yholinocomun/plant_ide/balancin/data/sim_fopid.png

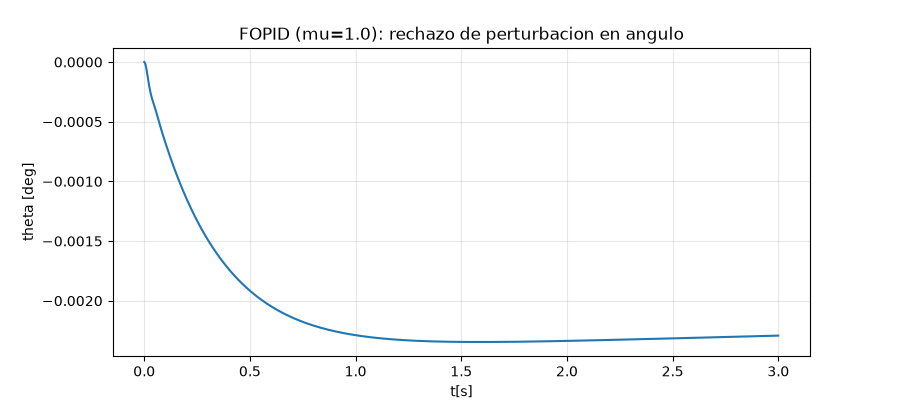
balancin/data/sim_fopid.png
