yholinocomun/plant_ide/balancin/data/sim_hinf.png

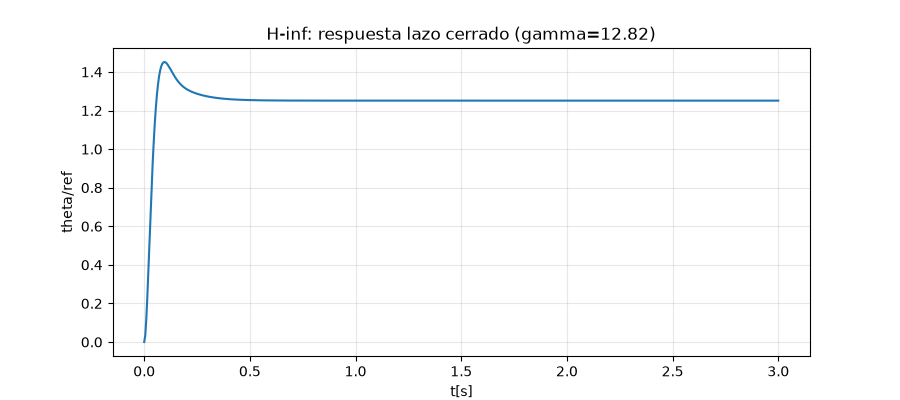
balancin/data/sim_hinf.png
