yholinocomun/plant_ide/balancin/data/sim_imc.png

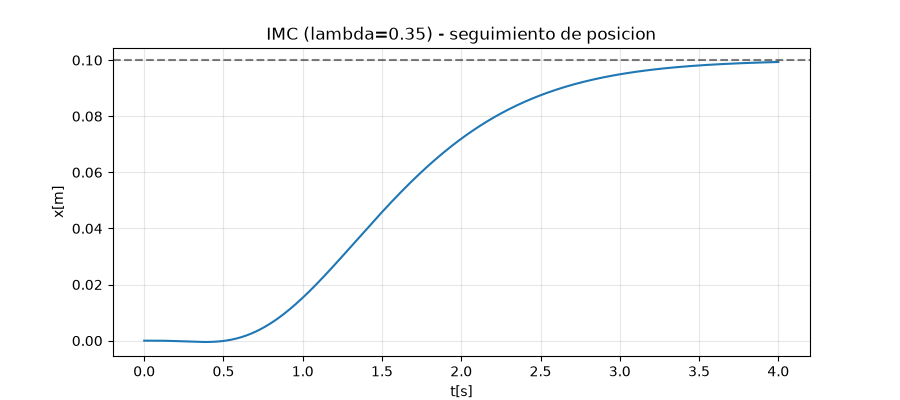
balancin/data/sim_imc.png
