yholinocomun/plant_ide/balancin/data/sim_lqg.png

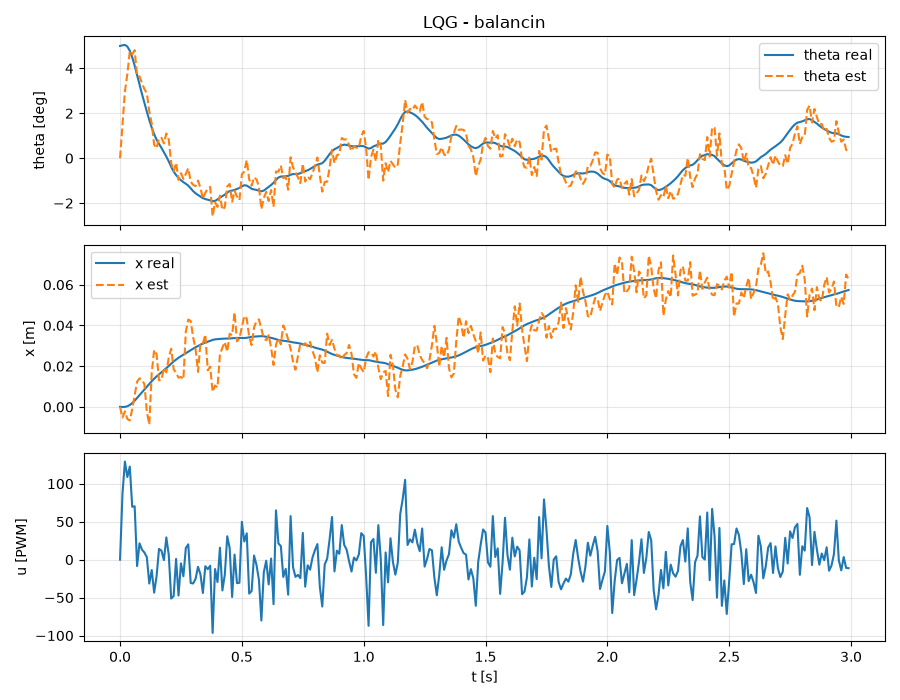
balancin/data/sim_lqg.png
