yholinocomun/plant_ide/balancin/data/sim_mpc.png

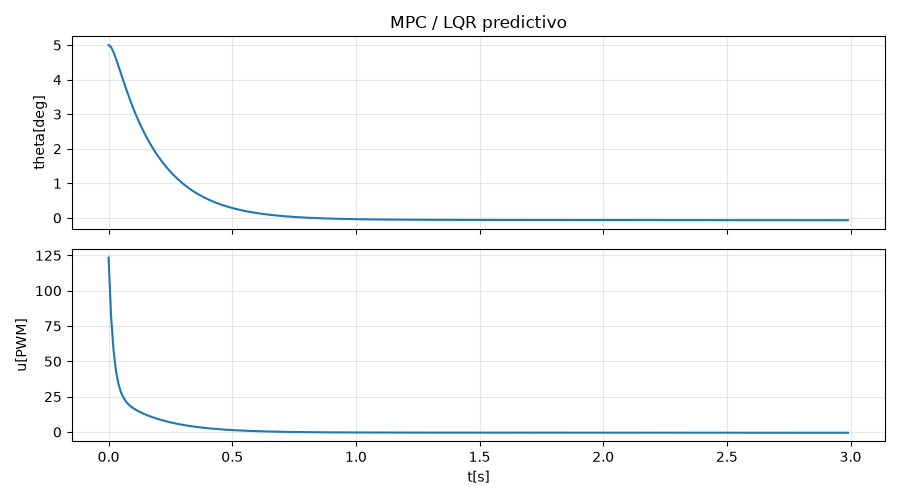
balancin/data/sim_mpc.png
