yholinocomun/plant_ide/balancin/proyecto/matlab_comparativa/cascada_sim.png

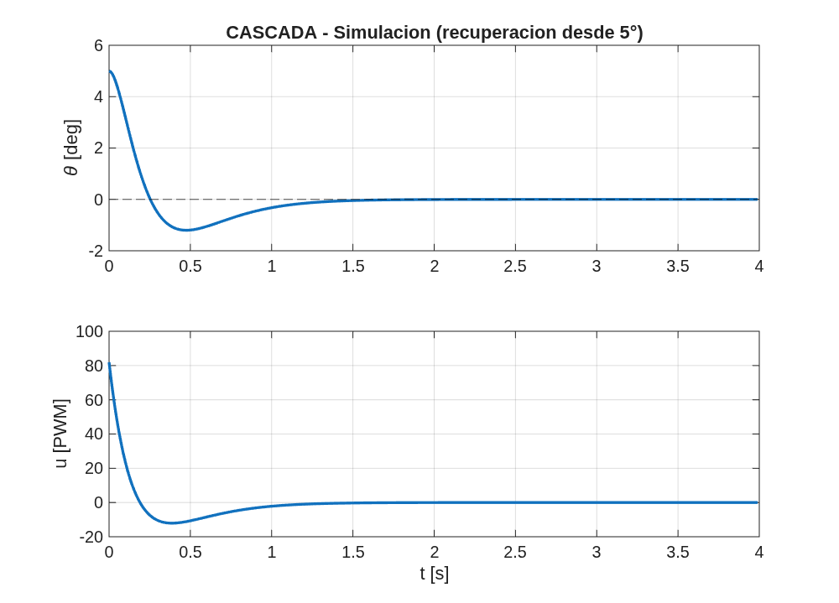
balancin/proyecto/matlab_comparativa/cascada_sim.png
