yholinocomun/plant_ide/balancin/proyecto/matlab_comparativa/fopid_comparativa.png

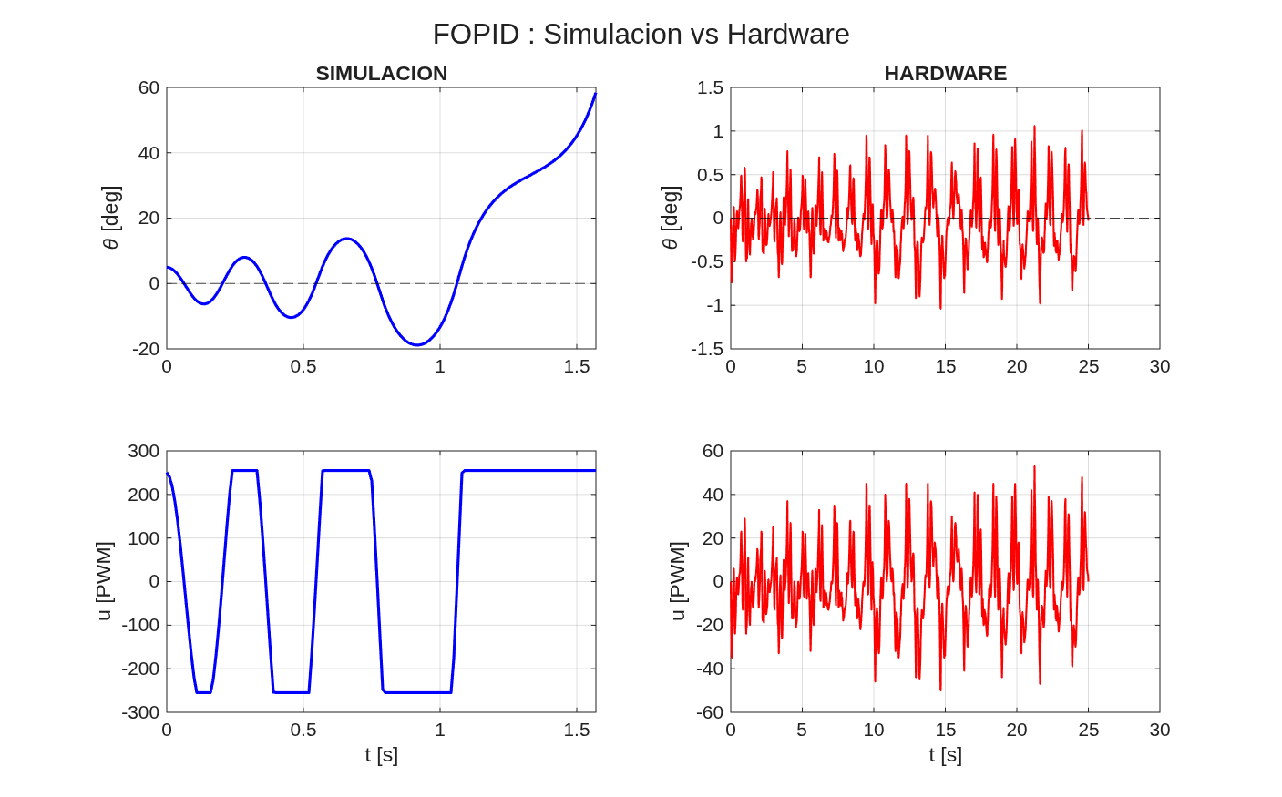
balancin/proyecto/matlab_comparativa/fopid_comparativa.png
