yholinocomun/plant_ide/balancin/proyecto/matlab_comparativa/fopid_sim.png

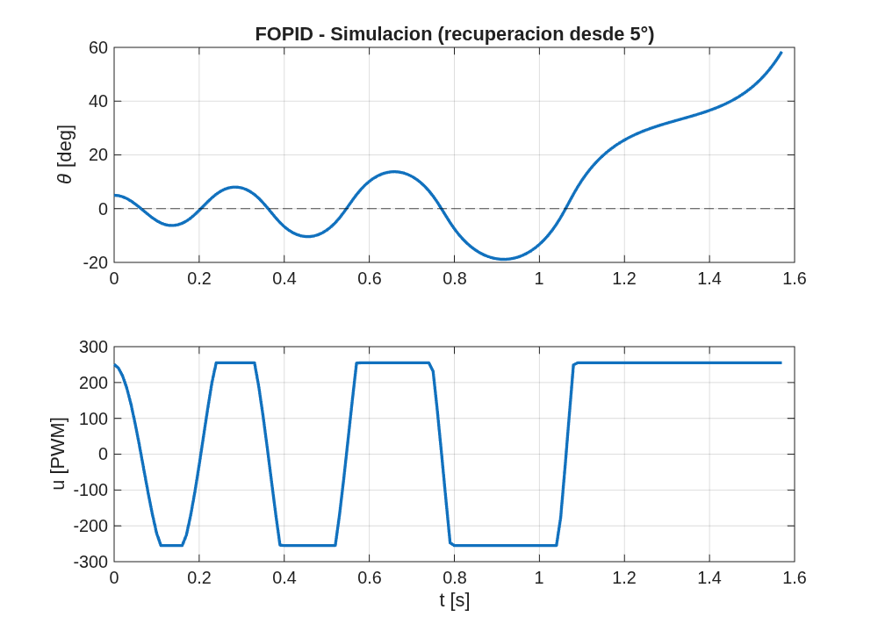
balancin/proyecto/matlab_comparativa/fopid_sim.png
