yholinocomun/plant_ide/balancin/proyecto/matlab_comparativa/hinf_sim.png

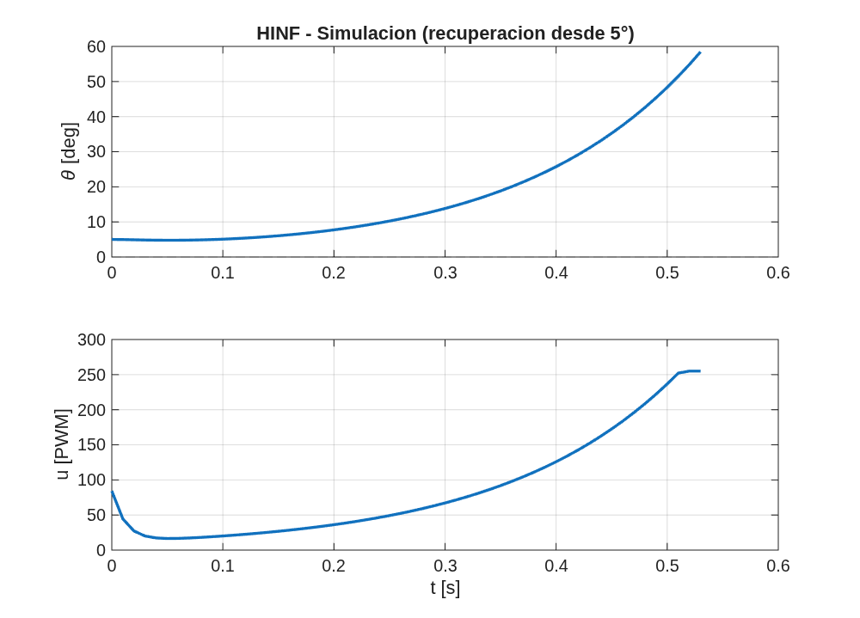
balancin/proyecto/matlab_comparativa/hinf_sim.png
