yholinocomun/plant_ide/balancin/proyecto/matlab_comparativa/imc_sim.png

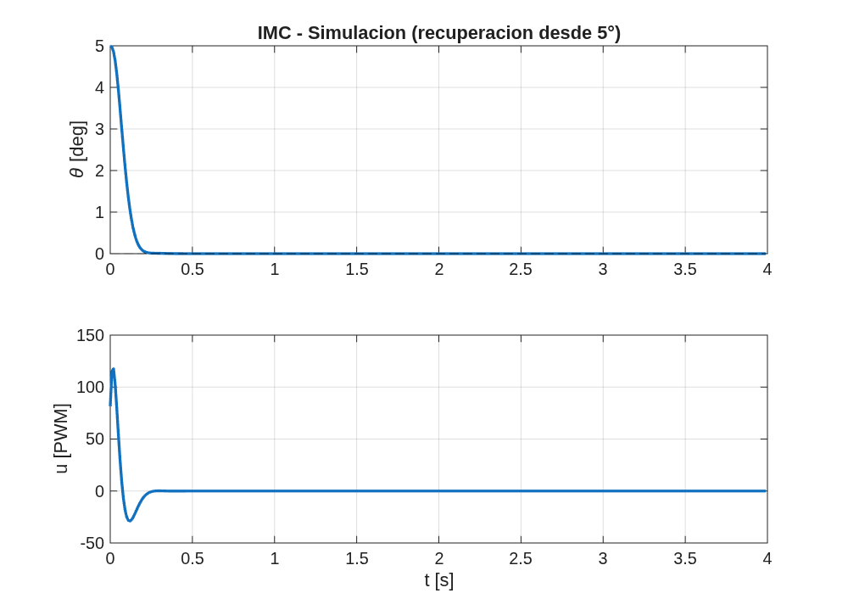
balancin/proyecto/matlab_comparativa/imc_sim.png
