yholinocomun/plant_ide/balancin/proyecto/matlab_comparativa/lqr_sim.png

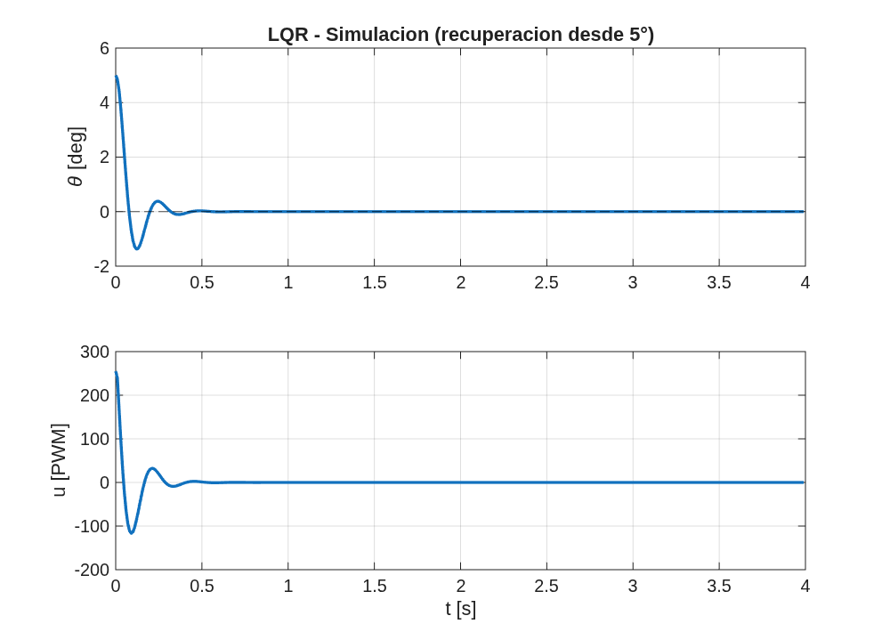
balancin/proyecto/matlab_comparativa/lqr_sim.png
