yholinocomun/plant_ide/plots/validacion_planta.png

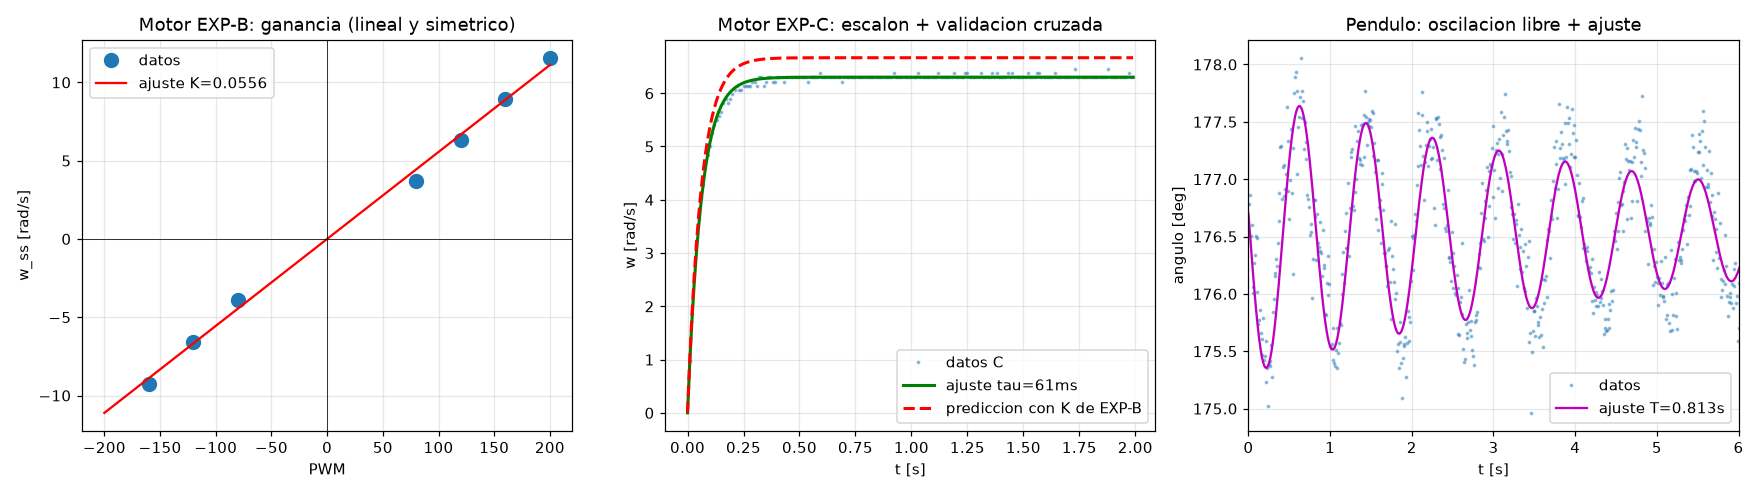
plots/validacion_planta.png
