yholinocomun/plant_ide/balancin/proyecto/resultados/cascada_20260709_092125.csv

t_ms | theta_deg | theta_dot_dps | x_m | x_dot_ms | u_pwm | setpoint_deg | modo
218.0 | -0.16 | 4.0 | 0.0007 | 0.0 | 4.0 | 0.0 | 0.0
238.0 | -0.11 | -0.9 | 0.0006 | 0.0 | -3.0 | 0.0 | 0.0
258.0 | -0.15 | 2.2 | 0.0006 | 0.0 | 1.0 | 0.0 | 0.0
278.0 | -0.1 | 1.0 | 0.0006 | 0.0 | 0.0 | 0.0 | 0.0
298.0 | -0.09 | 1.9 | 0.0006 | 0.0 | 1.0 | 0.0 | 0.0
318.0 | -0.03 | 1.5 | 0.0005 | -0.012 | 2.0 | 0.0 | 0.0
338.0 | -0.01 | 1.4 | 0.0005 | 0.0 | 2.0 | 0.0 | 0.0
358.0 | 0.02 | 1.0 | 0.0005 | 0.0 | 2.0 | 0.0 | 0.0
378.0 | 0.06 | 0.9 | 0.0005 | 0.0 | 2.0 | 0.0 | 0.0
398.0 | 0.08 | 1.1 | 0.0005 | 0.0 | 3.0 | 0.0 | 0.0
418.0 | 0.09 | 0.4 | 0.0005 | 0.0 | 2.0 | 0.0 | 0.0
438.0 | 0.11 | 1.2 | 0.0004 | 0.0 | 4.0 | 0.0 | 0.0
458.0 | 0.14 | 1.0 | 0.0002 | -0.012 | 4.0 | 0.0 | 0.0
478.0 | 0.16 | 0.9 | 0.0 | -0.012 | 5.0 | 0.0 | 0.0
498.0 | 0.2 | 0.4 | -0.0001 | -0.012 | 5.0 | 0.0 | 0.0
518.0 | 0.22 | -4.0 | -0.0005 | -0.024 | -2.0 | 0.0 | 0.0
538.0 | 0.15 | -3.8 | -0.0006 | 0.0 | -3.0 | 0.0 | 0.0
558.0 | 0.08 | 1.8 | -0.0006 | 0.0 | 5.0 | 0.0 | 0.0
578.0 | 0.15 | -3.8 | -0.0007 | 0.0 | -3.0 | 0.0 | 0.0
598.0 | 0.09 | 1.1 | -0.0007 | 0.0 | 4.0 | 0.0 | 0.0
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
