yholinocomun/plant_ide/balancin/proyecto/resultados/fopid_20260709_081821.csv

t_ms | theta_deg | theta_dot_dps | x_m | x_dot_ms | u_pwm | setpoint_deg | modo
219.0 | -0.0 | -20.8 | -0.0158 | -0.024 | 0.0 | 0.0 | 0.0
239.0 | -0.36 | -19.3 | -0.0161 | -0.012 | -17.0 | 0.0 | 0.0
259.0 | -0.65 | -11.4 | -0.0161 | 0.012 | -31.0 | 0.0 | 0.0
279.0 | -0.7 | -2.5 | -0.016 | 0.012 | -33.0 | 0.0 | 0.0
299.0 | -0.74 | 2.0 | -0.0157 | 0.024 | -35.0 | 0.0 | 0.0
319.0 | -0.57 | 1.9 | -0.0151 | 0.036 | -27.0 | 0.0 | 0.0
339.0 | -0.65 | 10.4 | -0.0145 | 0.036 | -32.0 | 0.0 | 0.0
359.0 | -0.28 | 14.6 | -0.014 | 0.024 | -13.0 | 0.0 | 0.0
379.0 | -0.08 | 5.3 | -0.0134 | 0.024 | -4.0 | 0.0 | 0.0
399.0 | -0.09 | 5.2 | -0.0128 | 0.024 | -4.0 | 0.0 | 0.0
419.0 | 0.07 | 7.9 | -0.0123 | 0.024 | 3.0 | 0.0 | 0.0
439.0 | 0.13 | -3.3 | -0.0121 | 0.012 | 6.0 | 0.0 | 0.0
459.0 | 0.02 | -10.0 | -0.0122 | -0.012 | 0.0 | 0.0 | 0.0
479.0 | -0.26 | -10.2 | -0.0122 | 0.0 | -12.0 | 0.0 | 0.0
499.0 | -0.43 | -3.9 | -0.0122 | 0.0 | -21.0 | 0.0 | 0.0
519.0 | -0.49 | -2.9 | -0.012 | 0.012 | -24.0 | 0.0 | 0.0
539.0 | -0.49 | 5.6 | -0.0117 | 0.012 | -24.0 | 0.0 | 0.0
559.0 | -0.37 | 6.2 | -0.0114 | 0.012 | -18.0 | 0.0 | 0.0
579.0 | -0.27 | 6.8 | -0.0109 | 0.024 | -14.0 | 0.0 | 0.0
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
