yholinocomun/plant_ide/balancin/proyecto/resultados/imc_20260709_080715.csv

t_ms | theta_deg | theta_dot_dps | x_m | x_dot_ms | u_pwm | setpoint_deg | modo
219.0 | 0.65 | 15.8 | -0.0012 | -0.012 | 41.0 | 0.0 | 0.0
239.0 | 1.08 | -5.2 | -0.0018 | -0.036 | 36.0 | 0.0 | 0.0
259.0 | 0.73 | -18.6 | -0.0024 | -0.036 | -5.0 | 0.0 | 0.0
279.0 | 0.59 | -0.3 | -0.0029 | -0.024 | 8.0 | 0.0 | 0.0
299.0 | 0.62 | 0.6 | -0.0031 | -0.012 | 17.0 | 0.0 | 0.0
319.0 | 0.65 | -7.1 | -0.0035 | -0.012 | 12.0 | 0.0 | 0.0
339.0 | 0.54 | -14.5 | -0.0039 | -0.024 | -7.0 | 0.0 | 0.0
359.0 | 0.31 | -1.5 | -0.0041 | 0.0 | -1.0 | 0.0 | 0.0
379.0 | 0.44 | 4.3 | -0.0041 | 0.0 | 17.0 | 0.0 | 0.0
399.0 | 0.56 | -5.0 | -0.0042 | -0.012 | 11.0 | 0.0 | 0.0
419.0 | 0.45 | -13.6 | -0.0044 | -0.012 | -5.0 | 0.0 | 0.0
439.0 | 0.19 | -8.2 | -0.0044 | 0.0 | -13.0 | 0.0 | 0.0
459.0 | 0.16 | -1.0 | -0.0043 | 0.012 | -2.0 | 0.0 | 0.0
479.0 | 0.15 | -6.5 | -0.0042 | 0.012 | -6.0 | 0.0 | 0.0
499.0 | 0.06 | -9.9 | -0.0042 | 0.0 | -16.0 | 0.0 | 0.0
519.0 | -0.09 | -10.9 | -0.0039 | 0.012 | -23.0 | 0.0 | 0.0
539.0 | -0.24 | -12.9 | -0.0036 | 0.024 | -33.0 | 0.0 | 0.0
559.0 | -0.47 | -5.6 | -0.0032 | 0.024 | -30.0 | 0.0 | 0.0
579.0 | -0.51 | -0.2 | -0.0026 | 0.024 | -20.0 | 0.0 | 0.0
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
