yholinocomun/plant_ide/balancin/proyecto/resultados/lqg_20260709_075331.csv

t_ms | theta_deg | theta_dot_dps | x_m | x_dot_ms | u_pwm | setpoint_deg | modo
212.0 | 0.23 | 9.2 | -0.2322 | -0.012 | 8.0 | 0.0 | 0.0
232.0 | 0.45 | 9.4 | -0.2324 | -0.012 | 10.0 | 0.0 | 0.0
252.0 | 0.69 | 9.1 | -0.2327 | -0.012 | 13.0 | 0.0 | 0.0
272.0 | 1.04 | 4.3 | -0.2331 | -0.012 | 18.0 | 0.0 | 0.0
292.0 | 1.06 | -10.3 | -0.2334 | -0.024 | 13.0 | 0.0 | 0.0
312.0 | 0.88 | -10.4 | -0.2339 | -0.024 | 5.0 | 0.0 | 0.0
332.0 | 0.81 | -10.7 | -0.2343 | -0.012 | 4.0 | 0.0 | 0.0
352.0 | 0.61 | -13.5 | -0.2347 | -0.024 | 0.0 | 0.0 | 0.0
372.0 | 0.48 | -9.0 | -0.235 | -0.012 | 0.0 | 0.0 | 0.0
392.0 | 0.34 | -11.1 | -0.2351 | -0.012 | -1.0 | 0.0 | 0.0
412.0 | 0.17 | -8.5 | -0.2352 | 0.0 | -3.0 | 0.0 | 0.0
432.0 | 0.06 | -6.3 | -0.2351 | 0.0 | -3.0 | 0.0 | 0.0
452.0 | -0.07 | -10.1 | -0.235 | 0.012 | -4.0 | 0.0 | 0.0
472.0 | -0.3 | -10.3 | -0.2349 | 0.0 | -8.0 | 0.0 | 0.0
492.0 | -0.48 | -9.7 | -0.2346 | 0.012 | -9.0 | 0.0 | 0.0
512.0 | -0.71 | -11.0 | -0.2344 | 0.012 | -12.0 | 0.0 | 0.0
532.0 | -0.92 | -8.2 | -0.234 | 0.024 | -14.0 | 0.0 | 0.0
552.0 | -1.09 | -1.1 | -0.2338 | 0.012 | -15.0 | 0.0 | 0.0
572.0 | -1.12 | 3.2 | -0.2334 | 0.024 | -12.0 | 0.0 | 0.0
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
