yholinocomun/plant_ide/balancin/proyecto/resultados/lqr_20260709_074337.csv

t_ms | theta_deg | theta_dot_dps | x_m | x_dot_ms | u_pwm | setpoint_deg | modo
212.0 | -0.45 | -5.4 | 0.0033 | 0.024 | -37.0 | 0.05 | 0.0
232.0 | -0.51 | 26.7 | 0.0037 | 0.012 | 17.0 | 0.05 | 0.0
252.0 | -0.01 | 12.7 | 0.0039 | 0.0 | 22.0 | 0.05 | 0.0
272.0 | 0.13 | -1.8 | 0.0037 | -0.012 | 4.0 | 0.05 | 0.0
292.0 | 0.03 | -2.9 | 0.0035 | -0.012 | -3.0 | 0.05 | 0.0
312.0 | 0.05 | 3.1 | 0.0032 | -0.012 | 8.0 | 0.05 | 0.0
332.0 | 0.1 | 3.4 | 0.0031 | -0.012 | 12.0 | 0.05 | 0.0
352.0 | 0.26 | -0.1 | 0.0029 | -0.012 | 15.0 | 0.05 | 0.0
372.0 | 0.22 | -10.6 | 0.0025 | -0.012 | -5.0 | 0.05 | 0.0
392.0 | 0.04 | -8.0 | 0.0024 | 0.0 | -11.0 | 0.05 | 0.0
412.0 | -0.02 | -1.0 | 0.0024 | 0.0 | -3.0 | 0.05 | 0.0
432.0 | -0.0 | -3.1 | 0.0025 | 0.0 | -5.0 | 0.05 | 0.0
452.0 | -0.06 | -4.5 | 0.0027 | 0.012 | -11.0 | 0.05 | 0.0
472.0 | -0.16 | -5.0 | 0.0029 | 0.012 | -18.0 | 0.05 | 0.0
492.0 | -0.28 | -4.6 | 0.0032 | 0.024 | -25.0 | 0.05 | 0.0
512.0 | -0.4 | 8.1 | 0.0036 | 0.012 | -9.0 | 0.05 | 0.0
532.0 | -0.12 | 12.0 | 0.0039 | 0.012 | 14.0 | 0.05 | 0.0
552.0 | -0.06 | -6.1 | 0.0039 | 0.0 | -14.0 | 0.05 | 0.0
572.0 | -0.21 | 0.7 | 0.0039 | 0.0 | -11.0 | 0.05 | 0.0
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
