yholinocomun/plant_ide/balancin/proyecto/resultados/lqr_20260709_113400.png

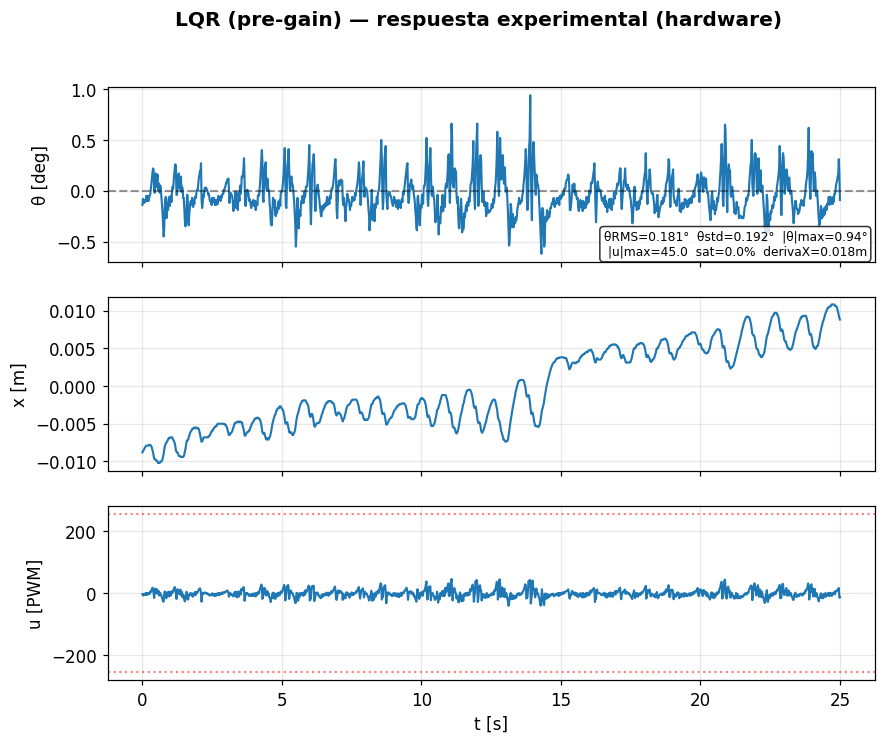
balancin/proyecto/resultados/lqr_20260709_113400.png
