yholinocomun/plant_ide/balancin/proyecto/resultados/lqr_20260709_114224.png

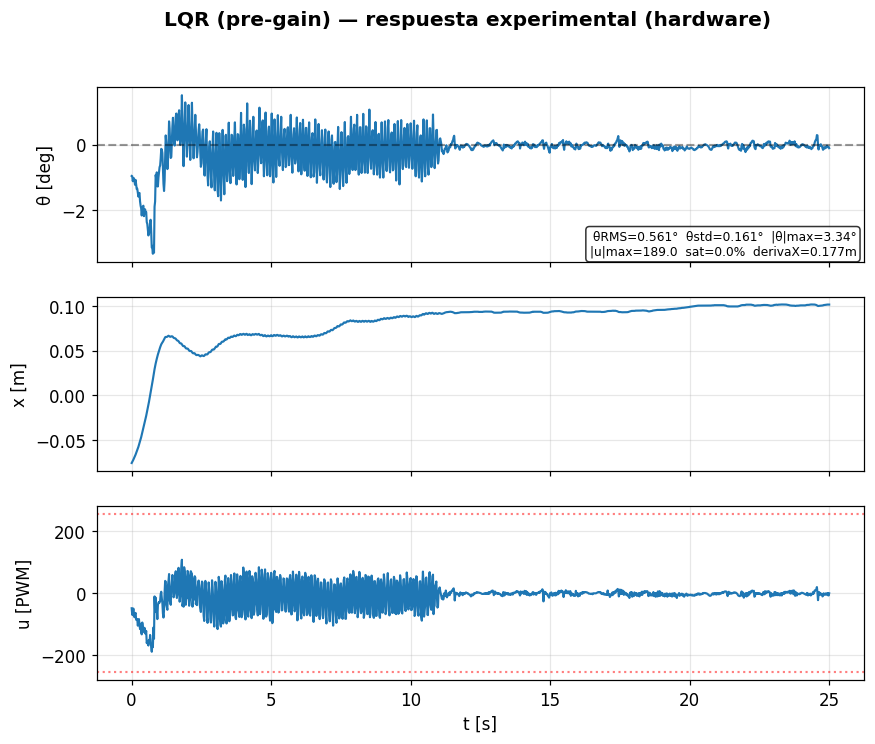
balancin/proyecto/resultados/lqr_20260709_114224.png
