yholinocomun/plant_ide/(commit log)

2026-06-26 Add plant identification workspace for inverted pendulum
    - ESP32-S3 firmware with PRBS/step/manual excitation modes, sends
    state vector [x, x_dot, theta, theta_dot] + PWM over Serial CSV
    - Python acquisition script: serial reader, live plot, CSV export,
    analytical state-space model, K_pwm regression, controllability/
    observability checks
    - Workspace structure: firmware/, python_tools/, data/, plots/
2026-06-28 Add by-phase plant identification (WIP model)
    Grey-box identification split into dedicated experiments:
    - exp1_motor.ino: ramp (deadband), staircase (K), step (tau)
    - exp2_pendulo.ino: free oscillation via gyro -> I_p
    - analizar_motor.py / analizar_pendulo.py: offline analysis + plots
    - ensamblar_modelo.py: wheeled inverted pendulum state-space
    (includes wheel rotational inertia J_w/r^2, torque input),
    eigenvalues, controllability/observability checks
    Hardware params: JGA25-370B, 74.8:1, GM25-13CPR, PPR=1945
    [analizar_motor.py, analizar_pendulo.py, ensamblar_modelo.py, exp1_motor.ino, exp2_pendulo.ino]
2026-06-28 Add preflight verification script and step-by-step data guide
    - verificar_setup.py: checks libraries, serial port access,
    ESP32 response, and live encoder counting before experiments
    - GUIA_TOMA_DATOS.md: explains encoder pulses->position/velocity,
    preflight checklist, and automated per-phase capture commands
2026-06-29 Update PARAMS with real measured values
    M=0.710kg (body), m_w=0.095kg, r=0.037m, l=0.10m
    I_p provisional (point-mass lower bound) pending Phase 2 measurement
2026-06-29 Clean workspace and update docs with real parameters
    - Remove obsolete monolithic files (esp32_data_collector, collect_data.py)
    superseded by the by-phase identification approach
    - Update GUIA_TOMA_DATOS.md: real params (M=0.710, m_w=0.095, r=0.037,
    l=0.10), add missing Phase 3 (J_w formula) section
    - Rewrite README.md to reflect clean by-phase structure
2026-06-29 Record Phase 1 motor results (real captured data)
    Motor model: G(s) = 0.0527/(0.060s+1)
    - K=0.0527 rad/s/PWM, tau=0.060s, u_dead=30 PWM
    - Linear, near-symmetric (asymmetry 0.967)
    - Small tau enables both cascade PID and LQR
2026-06-29 Robust period detection + physical validation in pendulum analysis
    The first capture gave T=0.46s with negative I_cm (impossible):
    gyro noise caused false zero-crossings inflating the frequency.
    - Low-pass filter (Butterworth 5Hz) before crossing detection
    - Hysteresis on zero-crossings (signal must exceed threshold)
    - FFT cross-check; outlier period rejection
    - Physical validity check: warn if T < 2*pi*sqrt(l/g) (impossible)
    [analizar_pendulo.py]
2026-06-29 Complete plant identification with real I_p (Phase 2)
    Final WIP state-space model, all parameters measured:
    - I_p=0.01164 kg·m² (T=0.812s, validated)
    - Unstable pole +7.14 rad/s, controllable & observable
    - Add resultados/fase2_pendulo.md and modelo_final.md
    [ensamblar_modelo.py]
2026-06-29 Add LQR controller design (Phase 5)
    diseno_lqr.py: solves continuous ARE for optimal gains,
    checks closed-loop stability, simulates response, and prints
    ESP32-ready gain constants. Tunable Q/R via CLI.
    Default design: stable closed loop, gains
    k=[-1.0, -6.55, -20.79, -4.53]
    [diseno_lqr.py]
2026-06-29 Add final LQR balancing firmware (no external libraries)
    control_lqr.ino: direct I2C MPU6050 read, encoder interrupts,
    complementary filter, LQR control law u=-(k1*x+k2*xd+k3*th+k4*thd),
    deadband compensation (U_DEAD=30), fall safety cutoff, 100Hz loop.
    Gains from diseno_lqr.py. Includes INVERTIR_CONTROL and SETPOINT_THETA
    for field calibration.
2026-06-29 Tune LQR firmware for first real balance test
    Telemetry showed control effort ~3 PWM (dominated by deadband) and
    frozen encoders (x stuck at 0.005). Fixes:
    - Aggressive angle gains k3=-484.6, k4=-154.1 (R=0.0005) so the
    control term clears the 30 PWM deadband at meaningful angles
    - Disable x/x_dot terms (k1=k2=0) for first test until encoders fixed
2026-06-29 Fix motors not driven: control_on now defaults true
    Telemetry printed computed u while motors stayed at 0 because the
    control_on gate required an 'S' command first (the working PID code
    has no such gate). Default control_on=true so motors drive from boot
    like the PID sketch; 'T' still stops, 'S' re-enables.
2026-06-29 Add LQR v1 firmware with design gains for sim-vs-hardware validation
    Uses the original design gains k=[-1.0,-6.55,-20.79,-4.53] (Q=diag
    (1,1,100,10), R=1), motors active from boot (no 'S' needed), and CSV
    telemetry (t_ms,theta,theta_dot,x,u) to compare against the simulation.
2026-06-29 Use recommended LQR gains (R=0.002) and non-latching safety
    - control_lqr now uses k3=-246, k4=-77 (middle ground: strong enough
    to clear deadband without being violent)
    - Non-latching fall safety (re-engages when upright)
    - Add gain tuning table to README
2026-06-29 Add practical self-balancing firmware with live tuning
    balance_final.ino: the version aimed at actually balancing.
    - Gyro bias calibration at boot (fixes angle drift that left theta
    stuck at ~6deg)
    - LIVE serial tuning (no reflashing): p/P Kp, d/D Kd, w/x setpoint,
    z auto-trim, i invert, space on/off
    - Works in degrees for intuitive tuning; PD law equivalent to
    angle-LQR; deadband compensation; non-latching safety
    - Motors start OFF for safety
2026-06-29 Keep plant ID + LQR design (Phases 0-5), drop balancing firmware
    Removes the Phase-6 self-balancing/control firmware (balance_final,
    control_lqr, control_lqr_v1). Retains the full grey-box plant
    identification (motor + pendulum), assembled state-space model and
    LQR controller design with their data-capture firmware and results.
    Claude-Session: https://claude.ai/code/session_014xGyrvjMDtAGcyFwPZLbNV
2026-06-29 Agrego data real capturada (motor y pendulo, 2026-06-28)
2026-06-29 Agrego data real capturada (motor A/B/C y pendulo, 2026-06-28)
    [motor_A_20260628_202239.csv, motor_B_20260628_202400.csv, motor_C_20260628_202442.csv, pendulo_20260628_212859.csv, pendulo_20260628_213317.csv]
2026-06-29 Fix plant model and validate against raw data + theory
    - Fix double-counting of M*l^2 in den (I_p is already about the pivot):
    unstable pole corrected from +7.14 to +10.23 rad/s. Also fix B vector.
    - Re-identify motor from raw encoders (K, tau, dead zone) with B->C
    cross-validation (6% RMSE) and nameplate check (1.7% on K).
    - Re-identify pendulum via damped-sinusoid fit (T=0.815s, I_p=0.01172,
    linear regime, RMSE 0.24 deg).
    - Add resultados/validacion_planta.md and validation plot.
    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
    [ensamblar_modelo.py, validar_motor.py]
2026-07-09 Add balancin/: 5 advanced controllers (sim MATLAB+Python + Arduino)
    LQG, MPC/LQR-predictivo, H-infinito, IMC y PID fraccionario disenados sobre
    la planta corregida (polo +10.23) con actuador calibrado. Cada uno con:
    simulacion Python (verificada: estabilizan) y MATLAB, e implementacion en
    Arduino (ganancia o controlador dinamico discreto). Incluye logger de datos
    Python+MATLAB para validar la implementacion.
    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
2026-07-09 Actualizar .gitignore para ignorar VS Code
2026-07-09 Add proyecto/: analysis + modular data extraction framework for 6 controllers
    - docs/analisis.md: analysis of the 6 tuned controllers (LQR, LQG, FOPID, MPC,
    IMC, H-inf) from the project markdown; control laws, gains, sim-vs-hardware.
    - docs/calculo_ganancias.md: uniform per-controller gain derivation.
    - config/controladores.py: single source of gains/metadata for the 6.
    - extraccion/: modular, uniform data extraction + standardized plotting
    (Python + MATLAB) + comparison table generator + uniform metrics + style.
    - firmware/BLOQUE_TELEMETRIA.md: uniform telemetry block to add to each .ino
    (justified) so one extractor serves all controllers. balance_MPC.ino supplied.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
2026-07-09 Standardize 6 firmwares + sim-vs-hardware comparison
    - firmware/: 6 standardized ESP32-S3 sketches (LQR, LQG, FOPID, MPC, IMC,
    H-inf) from the same template + integrated uniform telemetry ('t' key).
    FOPID via Grunwald-Letnikov fractional operators; H-inf as discrete IIR.
    - extraccion/simular_metricas.py: simulates the 6 with HW gains, saves
    _SIM.json (LQR/LQG/MPC/IMC stable; FOPID/H-inf don't stabilize the design
    plant with the hand-tuned gains -> documented sim-vs-hw gap).
    - comparativa.py: sim vs hardware table (resultados/tabla_comparativa.md).
    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
    [balance_FOPID.ino, balance_HINF.ino, balance_IMC.ino, balance_LQG.ino, balance_LQR.ino, comparativa.py, simular_metricas.py]
2026-07-09 Make extractor self-contained: sends z/space/t over serial (no Arduino Monitor needed)
    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
2026-07-09 Fix setpoint = -0.10 in all 6 firmwares; disable 'z' auto-trim
    User already found the zero point, so the equilibrium setpoint is now a fixed
    constant (-0.10) in every firmware and the 'z' key no longer modifies it (it
    only prints the fixed value). Extractor no longer sends 'z'; it just activates
    and logs.
    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
    [balance_FOPID.ino, balance_HINF.ino, balance_IMC.ino, balance_LQG.ino, balance_LQR.ino, balance_MPC.ino, extraer_datos.py]
2026-07-09 Use fixed MPU calibration in all 6 firmwares (no startup calibration)
    Adopt the fixed-zero scheme from the user's reference (only the calibration
    part, not the control logic/gains): GYRO_BIAS_FIJO=0.461259,
    ANGULO_CERO_FIJO=0.162628, SETPOINT_FIJO=0.0. Removes the 2s startup
    calibration and its prints; theta = (ang - ANGULO_CERO_FIJO) - SETPOINT_FIJO;
    gyro uses the fixed bias. No 'M' key added. Extractor no longer waits for
    calibration.
    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
    [balance_FOPID.ino, balance_HINF.ino, balance_IMC.ino, balance_LQG.ino, balance_LQR.ino, balance_MPC.ino, extraer_datos.py]
2026-07-09 Add cascade controller (fixed: pole placement instead of pole cancellation)
    The provided cascade-by-pole-cancellation cancels the UNSTABLE plant pole
    (+10.23) with a controller zero -> internally unstable (hidden +mode), verified.
    Corrected: same cascade structure and time constants (T22,T11) but genuinely
    stabilizing (inner P stabilizes P2 via w=theta_dot+alpha*theta, outer PI cancels
    only the stable pole). Adds balance_CASCADA.ino (fixed calibration + telemetry),
    sim_cascada.m, config + sim metrics entry. Nothing removed.
    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
    [balance_CASCADA.ino, simular_metricas.py]
2026-07-09 datos crudos de todos los controladores
    [cascada_20260709_092125.csv, fopid_20260709_081821.csv, hinf_20260709_084814.csv, imc_20260709_080715.csv, lqg_20260709_075331.csv, lqr_20260709_074337.csv]
2026-07-09 imagenes de todos los controladores
2026-07-09 imagenes de controlador general y imagen de control lgr de una amplitud y se estabiliza
    [lqr_20260709_113400.csv, lqr_20260709_114224.csv]
2026-07-09 Expand IEEE paper to ~6 pages (more theory, tables, discussion)
    Adds Related Work, Identification (params table), open-loop analysis,
    performance-index definitions, full per-controller equations (Riccati, dual
    Riccati/Kalman, cascade pole placement, Grunwald-Letnikov FOPID, IMC filter,
    Hinf mixed sensitivity), experimental methodology, and a 4-part discussion.
    9 sections, 16 equations, 3 tables, 2 figures, ~2800 words.
    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
2026-07-10 graficas comparativas de simulacion y de hadware codigo general mas comparativa
2026-07-10 comparar.m: H-inf now stabilizes in sim (new weights), overlaid sim-vs-HW figure with visible metrics, console print of overshoot/settling; exclude FOPID
    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
